quentinhqn/Projet-Maison-Connectee/(commit log)

2019-01-10 Create Modification de l'application "Bluetooth Terminal".md
2019-01-10 Update Modification de l'application "Bluetooth Terminal".md
